tikonen/telephone_box_driver/ui/assets/dialphone_dial.png

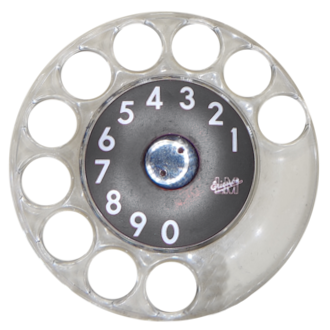
ui/assets/dialphone_dial.png
