tikonen/telephone_box_driver/ui/assets/dialphone_base.png

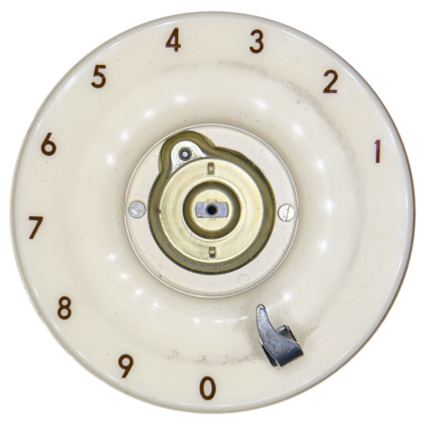
ui/assets/dialphone_base.png
