tikonen/telephone_box_driver/README.md

# Telephone Box driver

### Introduction

Interface library and test application for the Telephone Box Device.

Telephone Box Device hardware implements a virtual telephone exchange interface for a classic vintage rotary phone. Arduno Nano controls the logic and exposes a serial interface for the application. Supply requirement: 12V 1A.
See [Schematics](firmware/schematics) and [Interface Specification](firmware/telephone_box/README.md)

Package `telephonebox` is a low level interface for the Telephone Box serial interface.

`basicphone.py` is a base class for the applications that want to support the classic rotary phone logic, i.e. dial tone, dialing experience, ringing tone etc..

**SAFETY WARNING** Telephone Box produces up to 90 VAC voltage when physically ringing the phone bell and can give a very painful shock. Keep hands off the circuit board.

### Quickstart

1. Install Python libraries
* [sounddevice](https://pypi.org/project/sounddevice)
* [soundfile](https://pypi.org/project/soundfile)
* [numpy](https://pypi.org/project/numpy/)
* [pyserial](https://pypi.org/project/pyserial/)
* [serial-tool](https://pypi.org/project/serial-tool/)
2. Plugin in Telephone Box device power, usb and audio lines (out and mic). 
3. Run demo script to start the default demo application.

	```
	C:\projects\telephone_box_driver>python.exe phone_demo.py call
	Device port:  COM6
	Demo#1 Call handling
	Loading audio files.
	Connecting...
	Device initialized.
	*** IDLE (ONHOOK)
	```

### Troubleshooting
In connection errors you may need to install [CH340 driver](http://www.wch-ic.com/downloads/CH341SER_ZIP.html) for clone Arduino Nano compatibility. 

    ```serial.serialutil.SerialException: Cannot configure port, something went wrong. Original message: PermissionError(13, 'A device attached to the system is not functioning.', None, 31)
    ```

In case of clone Arduino Nano board that uses a fake CH340 chip see the following pages for possible solutions. https://github.com/SHWotever/SimHub/wiki/Arduino---Counterfeit-Fake-CH340G-chips-driver-issues and https://github.com/SHWotever/FakeCH340DriverFixer/

CH340 Driver version 04/11/2011 3.3.2011.11  seems to work fine with the counterfeit chips.
