tikonen/telephone_box_driver/firmware/notes/dial_pulses_v1.png

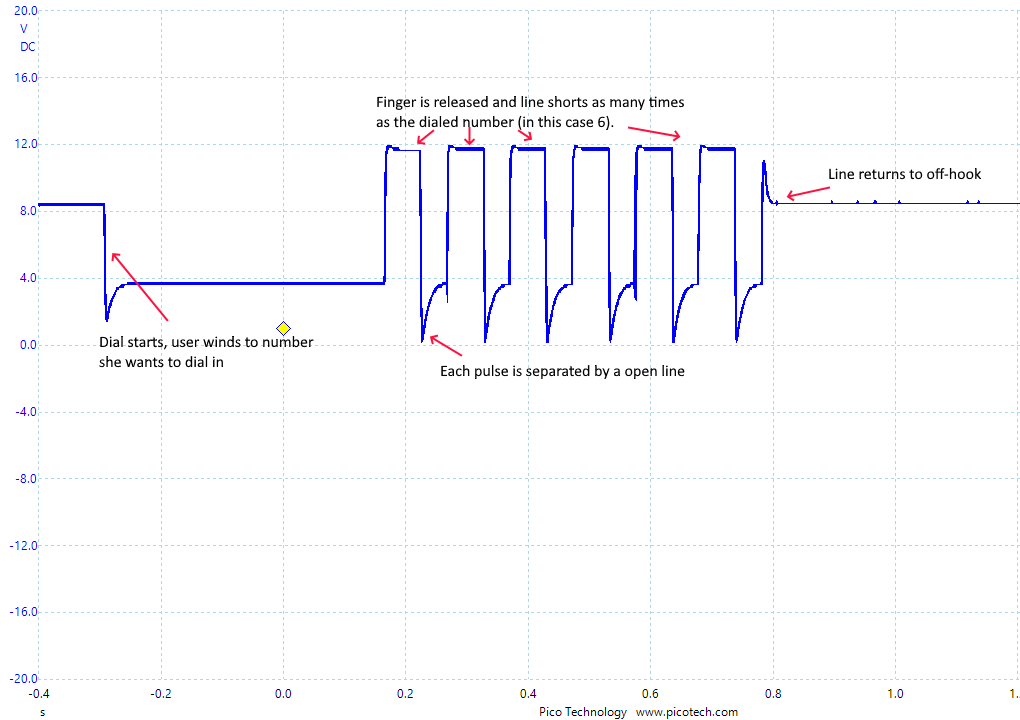
firmware/notes/dial_pulses_v1.png
