tikonen/telephone_box_driver/firmware/notes/dial_pulses_v2_20231227-dial1.png

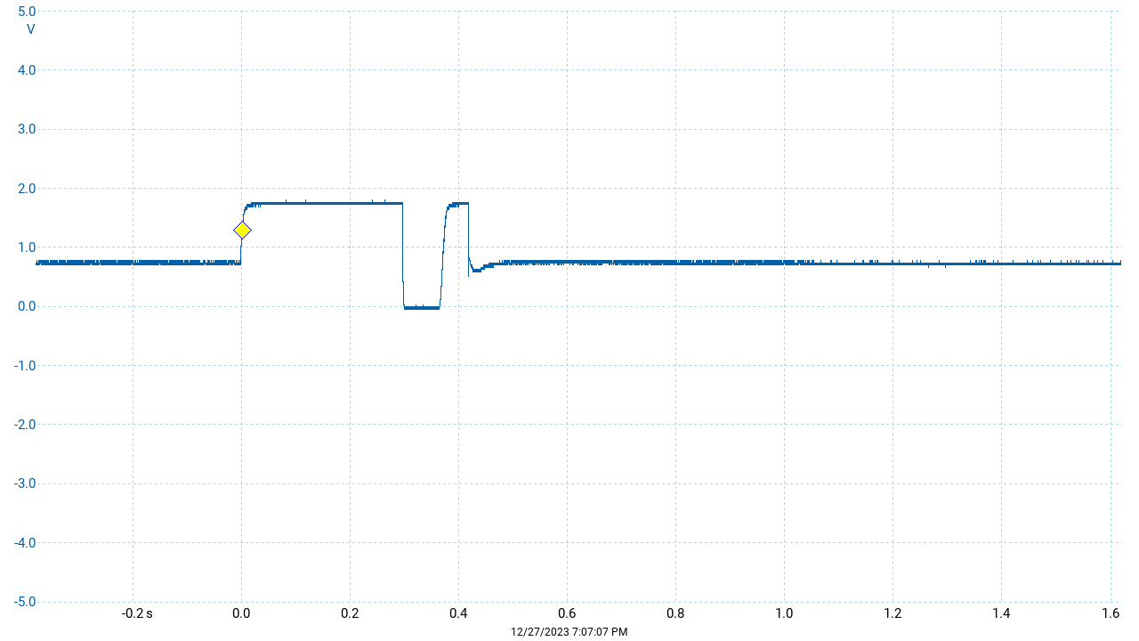
firmware/notes/dial_pulses_v2_20231227-dial1.png
