tikonen/telephone_box_driver/firmware/notes/dial_pulses_v2_20231227-dial6.png

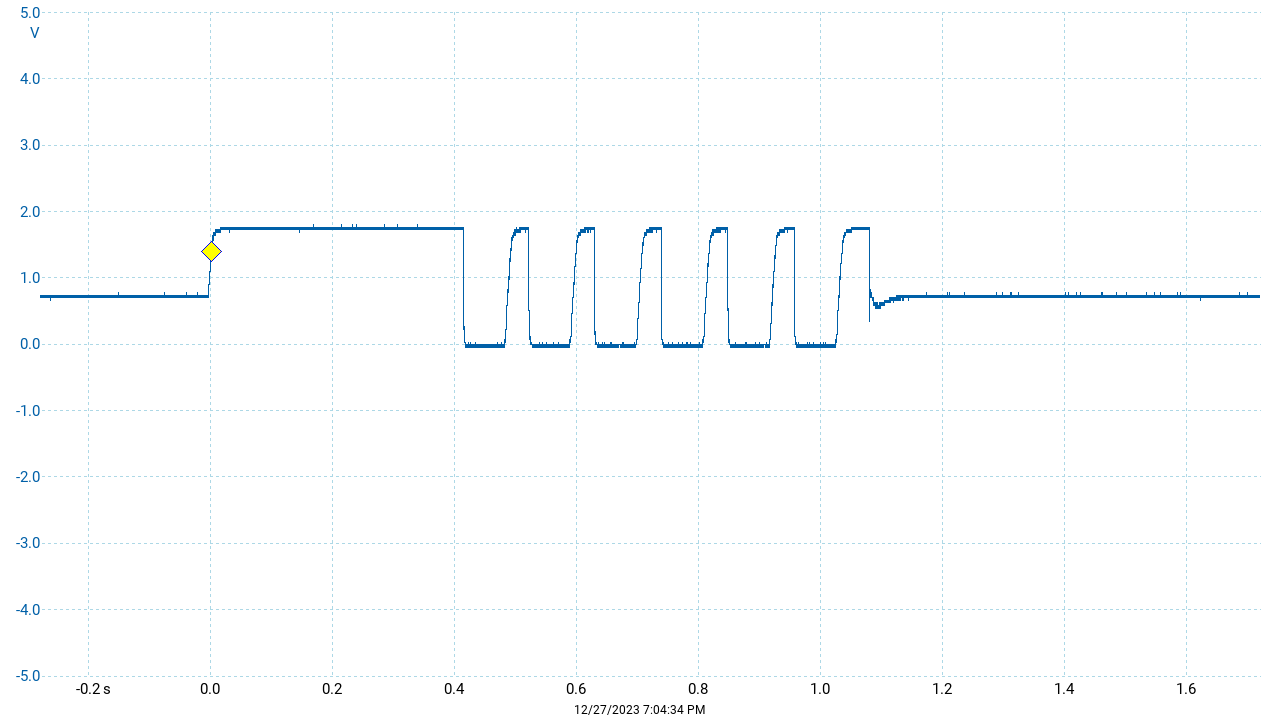
firmware/notes/dial_pulses_v2_20231227-dial6.png
