tikonen/telephone_box_driver/firmware/schematics/v2/phonebox v2 revc_Phone.png

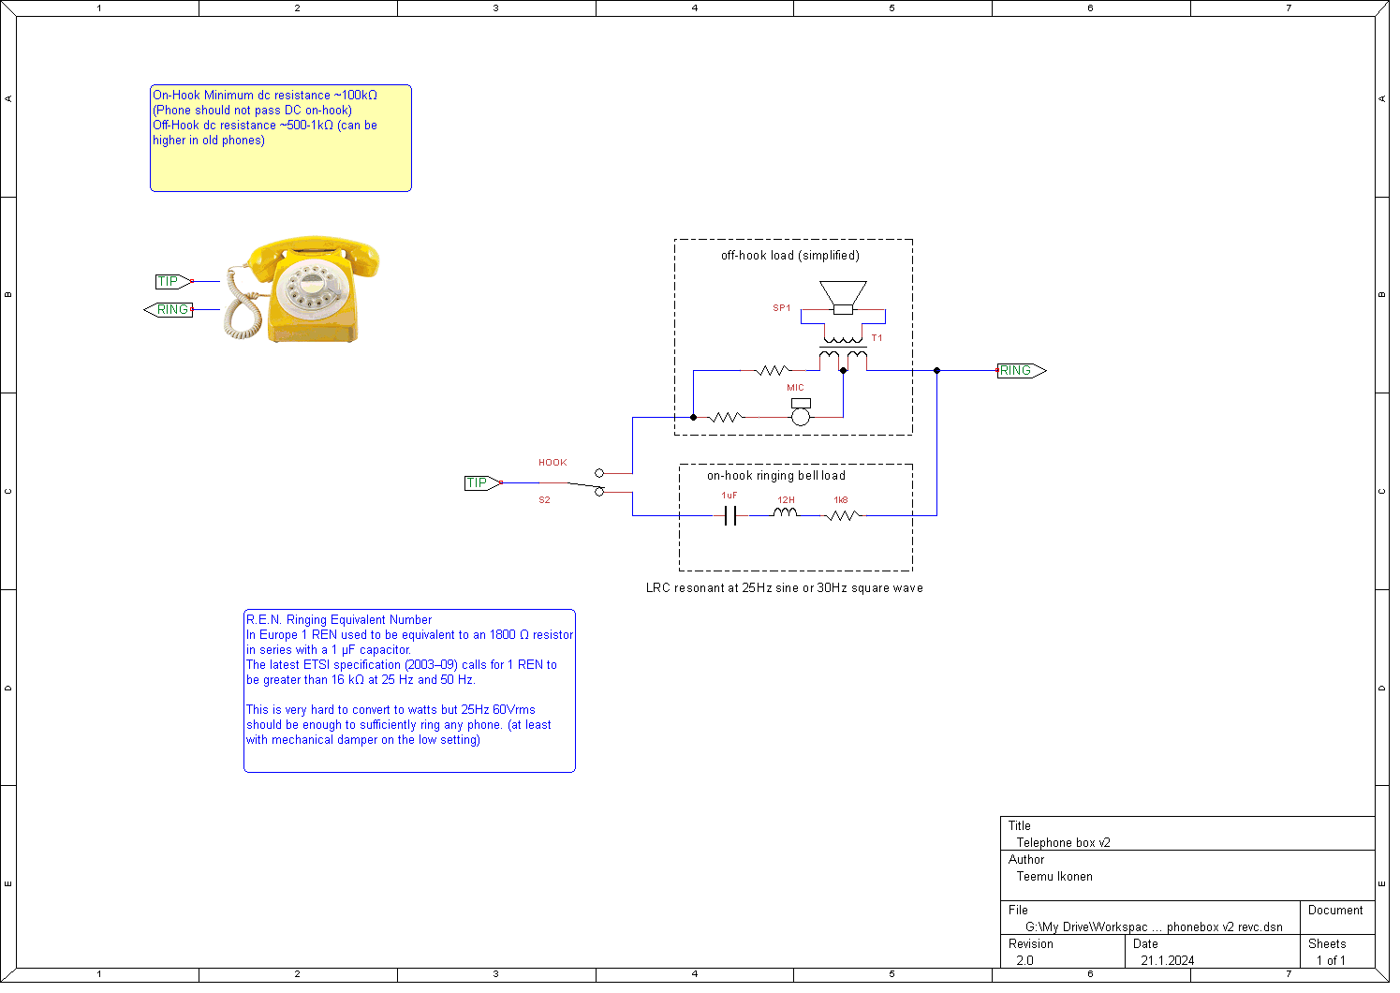
firmware/schematics/v2/phonebox v2 revc_Phone.png
