tikonen/telephone_box_driver/firmware/telephone_intercom/melody-mario.hpp

#pragma once
// Compression ratio 60.2%
// 34 unique keys. Key size 6 bits
const uint8_t mario_toneNotes[] PROGMEM = {0x22,0x00,0x61,0x00,0x67,0x00,0x82,0x00,0x92,0x00,0x9b,0x00,0xa4,0x00,0xae,0x00,0xb8,0x00,0xc3,0x00,0xcf,0x00,0xdc,0x00,0xe9,0x00,0xf6,0x00,0x05,0x01,0x15,0x01,0x25,0x01,0x49,0x01,0x5d,0x01,0x71,0x01,0x87,0x01,0x9f,0x01,0xb8,0x01,0xd2,0x01,0xed,0x01,0x0b,0x02,0x4b,0x02,0x6e,0x02,0x93,0x02,0xba,0x02,0xe3,0x02,0x0f,0x03,0x70,0x03,0x16,0x04,0x5f,0x04,0x58,0x44,0xdc,0x00,0x44,0xdc,0x00,0x44,0xdc,0x00,0x44,0xd9,0x00,0x44,0xdc,0x01,0x46,0x1f,0x00,0x95,0x09,0x50,0x02,0x51,0x64,0x01,0x8e,0x50,0x00,0xc9,0x44,0x01,0xce,0x58,0x02,0x50,0x60,0x02,0x0f,0x5c,0x01,0xce,0x58,0x01,0x8e,0x50,0x03,0x94,0x70,0x04,0x58,0x7c,0x04,0x99,0x80,0x04,0x16,0x74,0x04,0x58,0x7c,0x03,0x96,0x70,0x02,0xd1,0x64,0x03,0x52,0x68,0x02,0x50,0x60,0x02,0x51,0x64,0x01,0x8e,0x50,0x00,0xc9,0x44,0x01,0xce,0x58,0x02,0x50,0x60,0x02,0x0f,0x5c,0x01,0xce,0x58,0x01,0x8e,0x50,0x03,0x94,0x70,0x04,0x58,0x7c,0x04,0x99,0x80,0x04,0x16,0x74,0x04,0x58,0x7c,0x03,0x96,0x70,0x02,0xd1,0x64,0x03,0x52,0x68,0x02,0x50,0x60,0x00,0xc0,0x71,0xf7,0x1f,0x00,0x96,0xde,0x01,0xa7,0x5a,0x74,0x06,0x1b,0x61,0xb0,0x0e,0x01,0x97,0x19,0x70,0x01,0xc0,0x45,0x54,0x55,0x01,0x25,0x92,0x58,0x03,0x94,0x64,0x03,0x80,0x39,0x63,0x96,0x00,0x74,0x59,0x01,0x26,0x92,0x68,0x00,0xc0,0x71,0xf7,0x1f,0x00,0x66,0xde,0x01,0xa7,0x5a,0x74,0x06,0x1b,0x61,0xb0,0x09,0x00,0xe6,0x5c,0x01,0xd7,0xe1,0x01,0xd7,0xe1,0x01,0xd7,0xe1,0x00,0x90,0x03,0x01,0xc7,0xdc,0x7c,0x02,0x5b,0x78,0x06,0x9d,0x69,0xd0,0x18,0x6d,0x86,0xc0,0x38,0x06,0x5c,0x65,0xc0,0x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
#define mario_toneNotesHdrSize 68
#define mario_toneNotesEncSize 1119
#define mario_toneNotesSize 1189
// Compression ratio 74.1%
// 13 unique keys. Key size 4 bits
const uint8_t mario_toneDurations[] PROGMEM = {0x0d,0x00,0x0f,0x00,0x14,0x00,0x2f,0x00,0x5e,0x00,0x5f,0x00,0xbd,0x00,0xbe,0x00,0xc8,0x00,0x4c,0x01,0x4d,0x01,0xd9,0x01,0xdb,0x01,0xea,0x02,0x82,0x22,0x32,0x22,0x62,0x22,0x72,0x22,0x32,0x22,0x72,0x22,0xc2,0x22,0x2b,0x22,0x29,0x22,0x29,0x22,0x29,0x22,0x26,0x22,0x26,0x22,0x23,0x22,0x27,0x22,0x25,0x22,0x25,0x22,0x25,0x22,0x27,0x22,0x23,0x22,0x26,0x22,0x26,0x22,0x23,0x22,0x23,0x22,0x29,0x22,0x29,0x22,0x29,0x22,0x29,0x22,0x26,0x22,0x26,0x22,0x23,0x22,0x27,0x22,0x25,0x22,0x25,0x22,0x25,0x22,0x27,0x22,0x23,0x22,0x26,0x22,0x26,0x22,0x23,0x22,0x23,0x22,0x29,0x57,0x22,0x22,0x32,0x22,0x32,0x22,0x23,0x22,0x22,0x35,0x32,0x22,0x23,0x53,0x22,0x22,0x32,0x22,0x23,0x22,0x23,0x53,0x22,0x22,0x32,0x22,0x32,0x22,0x23,0x57,0x22,0x22,0x32,0x22,0x32,0x22,0x23,0x22,0x22,0x35,0x32,0x22,0x62,0x22,0x62,0x22,0x32,0x22,0x75,0x75,0x72,0x22,0x23,0x22,0x23,0x22,0x22,0x32,0x22,0x23,0x53,0x22,0x22,0x35,0x32,0x22,0x23,0x22,0x22,0x32,0x22,0x35,0x32,0x22,0x23,0x22,0x23,0x22,0x22,0x35,0x72,0x22,0x92,0x22,0x92,0x22,0x94,0x35,0x75,0x75,0x72,0x22,0x23,0x22,0x23,0x22,0x22,0x32,0x22,0x23,0x53,0x22,0x22,0x35,0x32,0x22,0x23,0x22,0x22,0x32,0x22,0x35,0x32,0x22,0x23,0x22,0x23,0x22,0x22,0x35,0x72,0x22,0x23,0x22,0x23,0x22,0x22,0x32,0x22,0x23,0x53,0x22,0x26,0x22,0x26,0x22,0x23,0x22,0x27,0x57,0x57,0x22,0x22,0x32,0x22,0x32,0x22,0x23,0x22,0x22,0x35,0x32,0x22,0x23,0x53,0x22,0x22,0x32,0x22,0x23,0x22,0x23,0x53,0x22,0x22,0x32,0x22,0x32,0x22,0x23,0x57,0x22,0x29,0x22,0x29,0x22,0x29,0x43,0x5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
#define mario_toneDurationsHdrSize 26
#define mario_toneDurationsEncSize 746
#define mario_toneDurationsSize 774
