tikonen/telephone_box_driver/firmware/telephone_intercom/melody-monkeyisland.hpp

# pragma once
// clang-format off
// Compression ratio 60.0%
// 34 unique keys. Key size 6 bits
const uint8_t monkey_toneNotes[] PROGMEM = {0x22,0x20,0x52,0x0,0x57,0x0,0x62,0x0,0x6e,0x0,0x7b,0x0,0x83,0x0,0x93,0x0,0x9c,0x0,0xa5,0x0,0xaf,0x0,0xb9,0x0,0xc4,0x0,0xdc,0x0,0xf7,0x0,0x6,0x1,0x26,0x1,0x37,0x1,0x4a,0x1,0x5d,0x1,0x72,0x1,0x88,0x1,0xb8,0x1,0xee,0x1,0xb,0x2,0x4b,0x2,0x93,0x2,0xe4,0x2,0x10,0x3,0x70,0x3,0xdc,0x3,0x17,0x4,0x97,0x4,0x27,0x5,0x1d,0x4,0x78,0x7,0x1a,0x5d,0x54,0x89,0x1,0x20,0x9,0x39,0x25,0x49,0x0,0xe4,0x95,0x24,0x5,0xc0,0x54,0x3,0x92,0x54,0x3,0x92,0x54,0x1,0xc0,0x40,0x3,0x50,0x50,0x70,0xd,0x41,0x41,0xd7,0x1d,0xa1,0xdc,0x1,0xe2,0x40,0x48,0x3,0x92,0x54,0x90,0xe,0x49,0x52,0x40,0x5c,0x5,0x40,0x39,0x25,0x40,0x39,0x25,0x40,0x1c,0x4,0x0,0x35,0x5,0x7,0x0,0xd4,0x14,0x1c,0x2,0x40,0x39,0x25,0x40,0x39,0x25,0x40,0x5d,0xa0,0x15,0x0,0xe4,0x95,0x68,0x3,0x92,0x55,0xc6,0xc0,0x68,0xd4,0x14,0x64,0xd4,0x14,0x0,0x0,0x1a,0x30,0xf4,0x86,0x0,0xc3,0xd2,0x18,0x30,0xc,0x39,0x6,0x4c,0x39,0x0,0x15,0x65,0x83,0xe,0x41,0x73,0xe,0x41,0x96,0x0,0x3c,0x3,0x4f,0x49,0x83,0x4f,0x48,0x5,0xc0,0x30,0xe4,0x81,0x0,0x0,0xe,0x48,0x10,0x17,0x68,0x10,0x1c,0x0,0x7,0x81,0x1,0x20,0x1a,0x39,0x25,0x5a,0x0,0xe4,0x95,0x1,0x76,0x8e,0x49,0x50,0xe,0x49,0x57,0x1b,0x68,0xd4,0x14,0x64,0xd4,0x14,0x0,0x60,0x1a,0x0,0xc3,0xd2,0x0,0x60,0xc,0x3d,0x21,0x80,0x48,0x3,0xf,0x48,0x3,0xf,0x49,0xb7,0x0,0x38,0x3,0xe,0x41,0xc3,0xe,0x40,0x5,0x9d,0x35,0xd3,0xc0,0x34,0xf0,0x1b,0x1c,0xd4,0x14,0x1c,0x3,0x50,0x50,0x7,0x1b,0x1,0xa3,0x50,0x51,0x96,0xcd,0x41,0x46,0xdc,0x70,0x0,0xc0,0x70,0xe4,0x15,0x70,0xe4,0x15,0x1,0xb1,0x4e,0x45,0x41,0x40,0x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
#define monkey_toneDurationsHdrSize 348
#define monkey_toneDurationsEncSize 1403
#define monkey_toneDurationsSize 1753
