tikonen/telephone_box_driver/firmware/rn52_telephone/rn52_telephone.ino

// Intentionally empty. See main.cpp
// Arduino IDE automatically generates function prototypes on file start when
// compiling .info files. This does not usually work if any function takes
// e.g. enum or other non-trivial types.
