tikonen/telephone_box_driver/firmware/telephone_intercom/melody-beverly.hpp

#pragma once
// Compression ratio 26.1%
// 10 unique keys. Key size 4 bits
const uint8_t beverly_toneNotes[] PROGMEM = {0x0a, 0x20, 0xee, 0x01, 0x4b, 0x02, 0x93, 0x02, 0xe4, 0x02, 0x10, 0x03, 0x70, 0x03, 0xdc, 0x03, 0x17, 0x04, 0x26,
    0x05, 0x0c, 0x00, 0x35, 0x33, 0x63, 0x23, 0x73, 0x38, 0x75, 0x37, 0x93, 0x22, 0x14, 0x30};
#define beverly_toneNotesHdrSize 20
#define beverly_toneNotesEncSize 12
#define beverly_toneNotesSize 34
// Compression ratio 54.3%
// 5 unique keys. Key size 3 bits
const uint8_t beverly_toneDurations[] PROGMEM = {
    0x05, 0x20, 0x6e, 0x00, 0xe6, 0x00, 0x54, 0x01, 0xcc, 0x01, 0x09, 0x00, 0x8d, 0x14, 0x94, 0x68, 0xa4, 0x92, 0x45, 0x14, 0xa0};
#define beverly_toneDurationsHdrSize 10
#define beverly_toneDurationsEncSize 9
#define beverly_toneDurationsSize 21
