tikonen/telephone_box_driver/firmware/telephone_intercom/melody-mk.hpp

#pragma once
// Compression ratio 72.1%
// 10 unique keys. Key size 4 bits
const uint8_t mk_toneNotes[] PROGMEM = {0x0a,0x00,0xa4,0x00,0xae,0x00,0xc4,0x00,0xdc,0x00,0xf6,0x00,0x05,0x01,0x25,0x01,0x49,0x01,0x88,0x01,0xc0,0x00,0x40,0x40,0x60,0x40,0x70,0x40,0x80,0x70,0x60,0x60,0x80,0x60,0x90,0x60,0x80,0x60,0x30,0x30,0x50,0x30,0x60,0x30,0x70,0x60,0x20,0x20,0x40,0x20,0x60,0x20,0x60,0x50,0x40,0x40,0x60,0x40,0x70,0x40,0x80,0x70,0x60,0x60,0x80,0x60,0x90,0x60,0x80,0x60,0x30,0x30,0x50,0x30,0x60,0x30,0x70,0x60,0x20,0x20,0x40,0x20,0x60,0x20,0x60,0x50,0x40,0x40,0x40,0x40,0x30,0x60,0x40,0x40,0x40,0x40,0x30,0x10,0x40,0x40,0x40,0x40,0x30,0x60,0x40,0x40,0x40,0x40,0x40,0x40,0x40,0x40,0x40,0x30,0x60,0x40,0x40,0x40,0x40,0x30,0x10,0x40,0x40,0x40,0x40,0x30,0x60,0x40,0x40,0x40,0x40,0x40,0x40,0x80,0x40,0x60,0x40,0x50,0x40,0x60,0x40,0x50,0x30,0x40,0x80,0x40,0x60,0x40,0x50,0x40,0x60,0x40,0x50,0x30,0x40,0x80,0x40,0x60,0x40,0x50,0x40,0x60,0x40,0x50,0x30,0x40,0x80,0x40,0x60,0x30,0x30,0x30,0x40,0x40,0x80,0x40,0x60,0x40,0x50,0x40,0x60,0x40,0x50,0x30,0x40,0x80,0x40,0x60,0x40,0x50,0x40,0x60,0x40,0x50,0x30,0x40,0x80,0x40,0x60,0x40,0x50,0x40,0x60,0x40,0x50,0x30,0x40,0x80,0x40,0x60,0x30,0x30,0x30,0x40};
#define mk_toneNotesHdrSize 20
#define mk_toneNotesEncSize 192
#define mk_toneNotesSize 214
// Compression ratio 79.4%
// 6 unique keys. Key size 3 bits
const uint8_t mk_toneDurations[] PROGMEM = {0x06,0x00,0x19,0x00,0x7d,0x00,0xc8,0x00,0xfa,0x00,0x77,0x01,0x90,0x00,0x71,0xc7,0x1c,0x71,0xc7,0x1c,0x71,0xc7,0x1c,0x71,0xc7,0x1c,0x71,0xc7,0x1c,0x71,0xc7,0x1c,0x71,0xc7,0x1c,0x71,0xc7,0x1c,0x71,0xc7,0x1c,0x71,0xc7,0x1c,0x71,0xc7,0x1c,0x71,0xc7,0x1c,0x71,0xc7,0x1c,0x71,0xc7,0x1c,0x71,0xc7,0x1c,0x71,0xc7,0x1c,0x75,0xd7,0x5d,0x71,0xc7,0x5d,0x75,0xd7,0x1c,0x75,0xd7,0x5d,0x71,0xc7,0x5d,0x75,0xd7,0x5d,0x75,0xd7,0x5c,0x71,0xd7,0x5d,0x75,0xc7,0x1d,0x75,0xd7,0x5c,0x71,0xd7,0x5d,0x75,0xd6,0x9c,0x69,0xc6,0x9c,0x69,0xc6,0x9a,0x71,0xa7,0x1a,0x71,0xa7,0x1a,0x71,0xa6,0x9c,0x69,0xc6,0x9c,0x69,0xc6,0x9c,0x69,0xa7,0x1a,0x71,0xa7,0x1a,0x71,0xa7,0x1a,0x71,0xa7,0x1a,0x71,0xa7,0x1a,0x69,0xc6,0x9c,0x69,0xc6,0x9c,0x69,0xc6,0x9a,0x71,0xa7,0x1a,0x71,0xa7,0x1a,0x71,0xa6,0x9c,0x69,0xc6,0x9c,0x69,0xc6,0x99};
#define mk_toneDurationsHdrSize 12
#define mk_toneDurationsEncSize 144
#define mk_toneDurationsSize 158
