tikonen/telephone_box_driver/firmware/telephone_intercom/melody-nyancat.hpp

#pragma once
// Compression ratio 65.7%
// 7 unique keys. Key size 3 bits
const uint8_t nyancat_toneNotes[] PROGMEM = {0x07, 0x40, 0x20, 0x03, 0x81, 0x03, 0xb7, 0x03, 0xef, 0x03, 0xae, 0x04, 0x41, 0x05, 0x15, 0x00, 0xba, 0x40, 0x5a,
    0x20, 0xa6, 0xd1, 0x52, 0xe9, 0x54, 0x28, 0xcb, 0xa5, 0x50, 0xb8, 0xd1, 0x4c, 0xa9, 0x54, 0x45, 0x14, 0x40};
#define nyancat_toneNotesHdrSize 14
#define nyancat_toneNotesEncSize 21
#define nyancat_toneNotesSize 37
// Compression ratio 79.6%
// 3 unique keys. Key size 2 bits
const uint8_t nyancat_toneDurations[] PROGMEM = {
    0x03, 0x40, 0x64, 0x00, 0xc8, 0x00, 0x0e, 0x00, 0xa5, 0x55, 0x5a, 0x95, 0x55, 0x55, 0x56, 0x95, 0x55, 0x55, 0x65, 0x55, 0x5a, 0xa0};
#define nyancat_toneDurationsHdrSize 6
#define nyancat_toneDurationsEncSize 14
#define nyancat_toneDurationsSize 22
