tikonen/telephone_box_driver/firmware/telephone_intercom/melody-pacman.hpp

#pragma once
// Compression ratio 34.8%
// 22 unique keys. Key size 5 bits
const uint8_t pacman_toneNotes[] PROGMEM = {0x16, 0x20, 0x13, 0x00, 0x26, 0x00, 0x7b, 0x00, 0x8a, 0x00, 0x9b, 0x00, 0xb8, 0x00, 0xc3, 0x00, 0xdc, 0x00, 0x05,
    0x01, 0x15, 0x01, 0x2a, 0x02, 0x4b, 0x02, 0x6e, 0x02, 0xba, 0x02, 0xe3, 0x02, 0x0f, 0x03, 0x3e, 0x03, 0x70, 0x03, 0x16, 0x04, 0x54, 0x04, 0xbc, 0x3d, 0x2c,
    0x00, 0xa8, 0x46, 0xb2, 0x50, 0x30, 0x0b, 0x8e, 0x6a, 0x40, 0x85, 0x71, 0xd6, 0xc2, 0x50, 0x32, 0x10, 0x5e, 0x8a, 0x48, 0x24, 0x1b, 0xd0, 0xb2, 0x52, 0x74,
    0x0c, 0x22, 0x16, 0xb8, 0xe5, 0xa4, 0x08, 0x17, 0x1d, 0xae, 0x78, 0x44, 0xf8, 0x06, 0x12, 0x0d, 0x12, 0xa4, 0x80};
#define pacman_toneNotesHdrSize 44
#define pacman_toneNotesEncSize 44
#define pacman_toneNotesSize 90
// Compression ratio 69.6%
// 7 unique keys. Key size 3 bits
const uint8_t pacman_toneDurations[] PROGMEM = {0x07, 0x00, 0x19, 0x00, 0x32, 0x00, 0x4b, 0x00, 0x64, 0x00, 0x7d, 0x00, 0x96, 0x00, 0x1a, 0x00, 0x84, 0xa6,
    0xd3, 0x4d, 0x14, 0xe1, 0xd5, 0x14, 0xd3, 0x25, 0xb6, 0x8b, 0x3a, 0xb4, 0xc9, 0x28, 0x92, 0xd1, 0x4e, 0x1b, 0x93, 0x64, 0xd8, 0x5e, 0x55, 0x92};
#define pacman_toneDurationsHdrSize 14
#define pacman_toneDurationsEncSize 26
#define pacman_toneDurationsSize 42
