tikonen/telephone_box_driver/firmware/telephone_intercom/melody-sandstorm.hpp

#pragma once
// Compression ratio 79.4%
// 5 unique keys. Key size 3 bits
const uint8_t sandstorm_toneNotes[] PROGMEM = {0x05, 0x20, 0x88, 0x01, 0xb8, 0x01, 0x0b, 0x02, 0x4b, 0x02, 0x7d, 0x00, 0x41, 0x04, 0x10, 0x41, 0x04, 0x10, 0x41,
    0x04, 0x20, 0x82, 0x08, 0x20, 0x82, 0x06, 0x18, 0x61, 0x86, 0x18, 0x60, 0x84, 0x10, 0x41, 0x04, 0x10, 0x41, 0x04, 0x10, 0x42, 0x08, 0x10, 0x41, 0x04, 0x10,
    0x41, 0x04, 0x10, 0x41, 0x08, 0x20, 0x41, 0x04, 0x10, 0x41, 0x04, 0x10, 0x41, 0x84, 0x10, 0x41, 0x04, 0x10, 0x41, 0x04, 0x18, 0x61, 0x04, 0x10, 0x41, 0x04,
    0x10, 0x41, 0x04, 0x20, 0x82, 0x08, 0x20, 0x81, 0x86, 0x18, 0x61, 0x86, 0x08, 0x41, 0x04, 0x10, 0x41, 0x04, 0x10, 0x41, 0x86, 0x10, 0x41, 0x04, 0x10, 0x41,
    0x04, 0x10, 0x61, 0x84, 0x10, 0x41, 0x86, 0x10, 0x41, 0x06, 0x18, 0x41, 0x04, 0x18, 0x61, 0x04, 0x10, 0x61, 0x84, 0x10, 0x61, 0x04, 0x18, 0x41, 0x06, 0x10,
    0x41, 0x84, 0x10, 0x61, 0x04, 0x18, 0x41, 0x06, 0x10, 0x41, 0x88, 0x20, 0x82, 0x00};
#define sandstorm_toneNotesHdrSize 10
#define sandstorm_toneNotesEncSize 125
#define sandstorm_toneNotesSize 137
// Compression ratio 78.8%
// 7 unique keys. Key size 3 bits
const uint8_t sandstorm_toneDurations[] PROGMEM = {0x07, 0x20, 0x0a, 0x00, 0x28, 0x00, 0x50, 0x00, 0xa0, 0x00, 0x40, 0x01, 0x80, 0x02, 0x7d, 0x00, 0x4d, 0x34,
    0xd3, 0x71, 0x34, 0xd3, 0x4d, 0x37, 0x13, 0x4d, 0x34, 0xd3, 0x4d, 0xc4, 0xd3, 0x4d, 0x34, 0xd3, 0x71, 0xc4, 0xd3, 0x4d, 0x37, 0x13, 0x4d, 0x34, 0xd3, 0x71,
    0x34, 0xd3, 0x4d, 0x34, 0xdc, 0x4d, 0x34, 0xd3, 0x4d, 0xc4, 0xd3, 0x4d, 0x37, 0x1c, 0x4d, 0x34, 0xd3, 0x72, 0x54, 0xd3, 0x71, 0xc4, 0xd3, 0x4d, 0x37, 0x1c,
    0x71, 0x34, 0xdc, 0x71, 0x34, 0xd3, 0x4d, 0xc7, 0x13, 0x4d, 0x34, 0xdc, 0x71, 0x34, 0xd3, 0x4d, 0xc7, 0x1c, 0x4d, 0x37, 0x1c, 0x4d, 0x34, 0xd3, 0x71, 0xc7,
    0x13, 0x4d, 0xc7, 0x13, 0x4d, 0x34, 0xdc, 0x71, 0xc4, 0xd3, 0x71, 0xc7, 0x13, 0x4d, 0xc7, 0x1c, 0x4d, 0x37, 0x1c, 0x71, 0x34, 0xdc, 0x71, 0xc4, 0xd3, 0x71,
    0x34, 0xdc, 0x4d, 0x37, 0x13, 0x4d, 0xc4, 0xd3, 0x71, 0x34, 0xdc, 0x4d, 0x37, 0x13, 0x4d, 0xcc, 0x71, 0xc7, 0x10};
#define sandstorm_toneDurationsHdrSize 14
#define sandstorm_toneDurationsEncSize 125
#define sandstorm_toneDurationsSize 141
