tikonen/telephone_box_driver/firmware/telephone_intercom/melody-taps.hpp

#pragma once
// Compression ratio 68.1%
// 5 unique keys. Key size 3 bits
const uint8_t taps_toneNotes[] PROGMEM = {0x05, 0x20, 0x88, 0x01, 0x0b, 0x02, 0x93, 0x02, 0x0f, 0x03, 0x12, 0x00, 0x20, 0x84, 0x08, 0x41, 0x82, 0x10, 0x60,
    0x84, 0x18, 0x21, 0x06, 0x10, 0x62, 0x06, 0x10, 0x20, 0x82, 0x10};
#define taps_toneNotesHdrSize 10
#define taps_toneNotesEncSize 18
#define taps_toneNotesSize 30
// Compression ratio 53.2%
// 9 unique keys. Key size 4 bits
const uint8_t taps_toneDurations[] PROGMEM = {0x09, 0x20, 0x40, 0x00, 0x80, 0x00, 0x00, 0x01, 0x80, 0x01, 0x00, 0x02, 0x00, 0x04, 0x00, 0x06, 0x00, 0x08, 0x18,
    0x00, 0x41, 0x21, 0x72, 0x41, 0x21, 0x72, 0x41, 0x21, 0x51, 0x41, 0x21, 0x51, 0x41, 0x21, 0x72, 0x31, 0x31, 0x61, 0x51, 0x51, 0x72, 0x41, 0x21, 0x80};
#define taps_toneDurationsHdrSize 18
#define taps_toneDurationsEncSize 24
#define taps_toneDurationsSize 44
