tikonen/telephone_box_driver/dtfmphone.py

import sys

from telephonebox import State
from basicphone import BasicPhone

import sounddevice as sd
import soundfile as sf
import queue

from goertzel import Goertzel, dtfm

SAMPLERATE = 14400
# Number of useable samples depends on the sample rate. Higher sample rates give better accuracy.
N = int(0.9 * dtfm.TONE_TIME * SAMPLERATE)

# Goertzel detector for each DTFM frequency
goertzels = [
    Goertzel(dtfm.FREQ_LOW1, N, SAMPLERATE),
    Goertzel(dtfm.FREQ_LOW2, N, SAMPLERATE),
    Goertzel(dtfm.FREQ_LOW3, N, SAMPLERATE),
    Goertzel(dtfm.FREQ_LOW4, N, SAMPLERATE),
    Goertzel(dtfm.FREQ_HIGH1, N, SAMPLERATE),
    Goertzel(dtfm.FREQ_HIGH2, N, SAMPLERATE),
    Goertzel(dtfm.FREQ_HIGH3, N, SAMPLERATE)
]


def resolvesymbol(threshold):
    freqs = []
    # check what detectors found their target frequency
    for g in goertzels:
        p = g.power()
        print(g.f, f'{p:2.2f}', end='')
        if p > threshold:
            freqs.append(g.f)
            print(' *')
        else:
            print()
    if len(freqs) == 2:
        # exactly two frequencies detected, find corresponding symbol
        for e in dtfm.SYMBOLS:
            if freqs[0] in e[1] and freqs[1] in e[1]:
                # symbol found
                (fl, fh) = e[1]
                print(
                    f'SYMBOL:"{e[0]}"', f'({fl}Hz, {fh}Hz)')
                return (True, e[0])
    else:
        print("NO SYMBOL")
        return (False, 0)


class DTFMPhone(BasicPhone):

    def __init__(self, port, verbose):
        super().__init__(port, verbose)

        # TODO configure dial mode to none
        # self.driver.command(Command.CONF, {'DM':'0'})

    def key(self, symbol):
        print(f'KEY {symbol}')

    # Phone is off-hook
    def wait(self):
        print("*** WAIT (OFFHOOK)")
        sd.play(self.dial_tone[0], self.dial_tone[1], loop=True)

        # Setup audio input and start monitoring dialoed numbers
        q = queue.Queue()

        def callback(indata, frames, time, status):
            """Called (from a separate thread) for each audio block."""
            if status:
                print(status, file=sys.stderr)
            q.put(indata.copy())

        ENVELOPE_THRESHOLD = 1.0

        def process(data):  # process received audio blocks
            for s in data:
                sample = s[0]
                process.ts += 1/SAMPLERATE  # timestamp
                t = process.ts
                # rough envelope detector
                process.envelope = 0.95*process.envelope + abs(sample)
                if process.envelope >= ENVELOPE_THRESHOLD:  # signal amplitude is strong enough
                    if not process.signalts:
                        # only consider signal if enough time has passed since the last one
                        interval = t - process.lastts
                        if interval > dtfm.PAUSE_TIME * 0.8:  # signal acquired
                            print(f'{t:.2f}s', "SIGNAL ON",
                                  f'{int(interval*1000)}ms')
                            process.signalts = t
                            process.envelopesample = 0
                            for g in goertzels:  # reset goertzel detectors
                                g.reset()
                else:  # no signal detected
                    if process.signalts:  # signal lost
                        duration = t - process.signalts
                        print(f'{t:.2f}s', "SIGNAL OFF",
                              f'{int(duration*1000)}ms')
                        if duration > dtfm.TONE_TIME * 0.8:  # ignore if too short signal
                            print(f'ENVELOPE {process.envelopesample:2.1f}')
                            (detect, symbol) = resolvesymbol(
                                process.envelopesample)
                            if detect:
                                self.key(symbol)
                                # sd.stop()  # Stop playing dial tone
                            process.lastts = t
                        process.signalts = 0
                    continue
                if process.signalts:
                    for g in goertzels:  # update detectors with the sample
                        if not g.ready():  # no need for new samples if already enough
                            # enough samples, store envelope status for thresholding
                            if g.update(sample):
                                process.envelopesample = process.envelope

        process.envelope = 0
        process.signalts = 0
        process.lastts = -dtfm.PAUSE_TIME
        process.envelopesample = 0
        process.ts = 0

        subtype = 'PCM_16'
        filename = 'dtfm_rec.wav'
        print("Recording to", filename)

        # open soundfile and start recording until user hangs up
        with sf.SoundFile(filename, mode='w', samplerate=SAMPLERATE,
                          channels=1, subtype=subtype) as file:

            istream = sd.InputStream(
                samplerate=SAMPLERATE, blocksize=0, channels=1, callback=callback)
            istream.start()

            while True:
                (ev, params, state) = self.update()
                if state != State.WAIT:
                    break
                try:
                    while True:
                        data = q.get(False)
                        file.write(data)
                        process(data)
                except queue.Empty:
                    pass
            istream.stop()
            istream.close()
        sd.stop()
