tikonen/telephone_box_driver/(commit log)

2022-10-05 Logic fixes and add missing hang up effects
    [basicphone.py, phone_demo.py]
2022-10-15 Update PWM enable to match circuit changes
2024-01-04 Testing board v2
2024-01-21 Reset timestamp on silence
    [dtmfphone.py]
2024-02-17 Add trip stabilization delay.
    Trip line may be unstable for the few initial ringing pulses. Wait for a
    while to let it stabilize.
    Fix bug where ringing timers were not properly reset after 500ms wait on
    ring state enter.
    Cosmetic changes.
    [main.cpp, main.hpp]
2024-02-17 Debugging help and updated schematics
2024-02-17 Filter dialing start better
2024-03-09 Open driver in main. Refactoring. Allow async commands.
2024-03-15 Round button mockups
2024-03-17 Timing fix and better keyboard handling
    [basicphone.py]
2024-03-17 All the buttons use same mouse state per update
2024-11-03 Fixup to stop melody
    [main.cpp]
2025-09-14 Minor bugfix on timer. Some docs
    [beepcompress.py, main.cpp]
2026-02-20 Fixes to number recognition
    Have a debounce in line state detection. It seems
    that some phones have bit bouncy switches that could cause
    too many pulses counted.
    Remove audio device check on demo. It raises an exception
    if no kind of device is available. (e.g. microphone)
    [beepcompress.py, main.cpp, main.hpp, phone_demo.py]
